ajgeemail/edpAutoCar/System Documentation/ODS powerpoint.pptx

## Obstacle Detection System - Black box

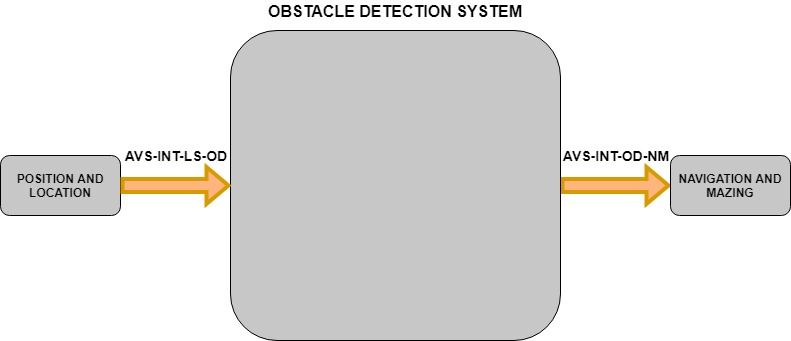
[picture p1: figure]

- Purpose: To detect and locate obstacles

Notes: I’ll be briefly talking to you about the Obstacle Detection System.
It’s purpose is to detect and locate obstacles and output their location to the navigation system for better route planning.

## Obstacle Detection System - Internal

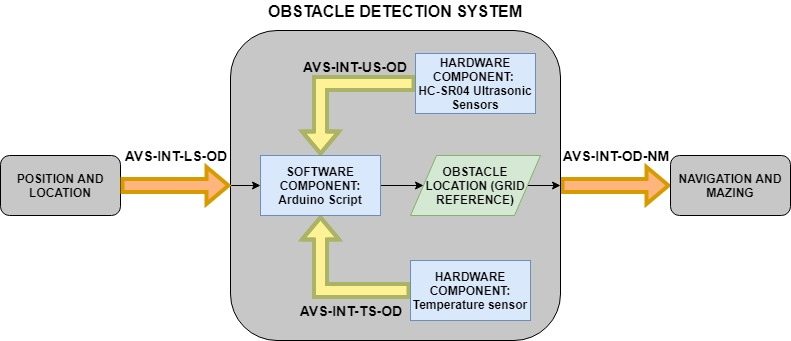
[picture p2: figure]

*if required*

Notes: Internally it will require up to three major interfacing components:
The Ultrasonic sensors
Temperature sensor if required
And the Arduino Script that will combine the inputs and convert into a grid reference to be outputted to the navigation system.

## Obstacle Detection System - Risks

Requirements | Risks
Minimum detect range ≤8cm (based on the geometry of the RC chassis). | Won't detect obstacle in next grid
Accuracy of ±10cm | Incorrect rounding of obstacle location due to smaller obstacle than grid square
Temperature range of 10 - 30°C | Error due to temperature will be outside limits
Obstacles placed in range of 85-95° | Sensors will not accurately detect obstacles
Obstacles placed in only one grid square | Obstacle only allocated to one of the grid squares

Mitigation

Have minimum offset from vehicle as possible

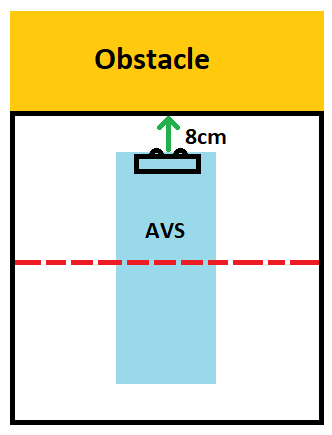
[picture p3: figure]

Notes: There are five major risk factors:
The system shall detect obstacles at a minimum range of ≤8cm .
Otherwise the system may not detect an obstacle in the adjacent grid as can be seen.
To minimise this risk the offset from the chassis will be as small as possible.

There are five major requirements and risk factors:
The system shall detect obstacles at a minimum range of ≤8cm (based on the geometry of the RC chassis).
Otherwise the system may not detect an obstacle in the adjacent grid as can be seen in the image.
Mitigation is to have as small an offset from the chassis as possible.

## Obstacle Detection System - Risks

Requirements | Risks
Minimum detect range ≤8cm (based on the geometry of the RC chassis). | Won't detect obstacle in next grid
Accuracy of ±10cm | Incorrect rounding of obstacle location due to smaller obstacle than grid square
Temperature range of 10 - 30°C | Error due to temperature will be outside limits
Obstacles placed in range of 85-95° | Sensors will not accurately detect obstacles
Obstacles placed in only one grid square | Obstacle only allocated to one of the grid squares

Mitigation

Add negative distance bias such that rounding will be correct

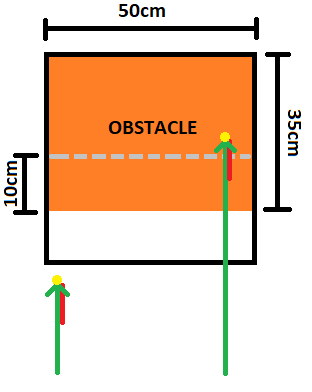
[picture p4: figure]

Notes: 2. The system shall detect obstacles with an accuracy of at least ±10cm.
Otherwise based on the difference in the sizes of the obstacles and squares, rounding may cause location errors.
If required, a distance bias will be added to correct rounding issues.
2. The system shall detect obstacles with an accuracy of at least ±10cm.
Otherwise based on the difference in the sizes of the obstacles and the grid references rounding will incorrectly allocate obstacle locations.
Mitigation as seen in the diagram, is to if required, add a negative distance bias (shown by the red line) to correct rounding issues.

## Obstacle Detection System - Risks

Requirements | Risks
Minimum detect range ≤8cm (based on the geometry of the RC chassis). | Won't detect obstacle in next grid
Accuracy of ±10cm | Incorrect rounding of obstacle location due to smaller obstacle than grid square
Temperature range of 10 - 30°C | Error due to temperature will be outside limits
Obstacles placed in range of 85-95° | Sensors will not accurately detect obstacles
Obstacles placed in only one grid square | Obstacle only allocated to one of the grid squares

Mitigation

Implement a temperature sensor if required

Temperature sensor comparison table:

Notes: 3. Since the speed of sound in air varies with temperature, the system shall operate in a temperature range of 10−30^o C .
Otherwise the error in the speed of sound will cause a distance error exceeding limits.
This range should be reasonable, but as a contingency, a temperature sensor has been selected based on the comparisons shown in the table.
3. Since the speed of sound in air varies with temperature, the system shall operate in a temperature range of 10−〖30〗^o C.
Otherwise the error in the speed of sound will cause a distance error exceeding ±7cm.
It has been determined that this range is reasonable, however if a higher degree of accuracy is needed a temperature sensor will be implemented. As can be seen in the table the sensors were compared based on the cost to error at max range benefit, and from this comparison a contingency component has been selected.

## Obstacle Detection System - Risks

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

Mitigation

Confirm with stakeholder if genuine risk, if so introduce a sweeping technique

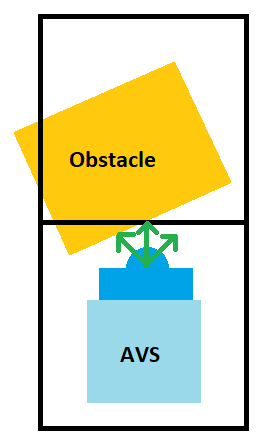
[picture p5: figure]

Notes: 4. The obstacles are expected to be placed at ±5^o relative to the grid otherwise the sensors may not work as they need a perpendicular surface.
A sweeping technique could be used to maximise the chance of getting a perpendicular surface.
4. The obstacles are expected to be in a range of 85−〖95〗^o relative to the grid as the sensors require a near perpendicular surface to operate.
If not, the sensors will not accurately and consistently detect the correct distance of the obstacles.
If it is confirmed by the stakeholder that this is a genuine risk, a sweeping technique will be introduced to maximise chance of getting perpendicular surface.

## Obstacle Detection System - Risks

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

Mitigation

Confirm with stakeholder if genuine risk, if so implement smaller detection grid-squares for higher resolution

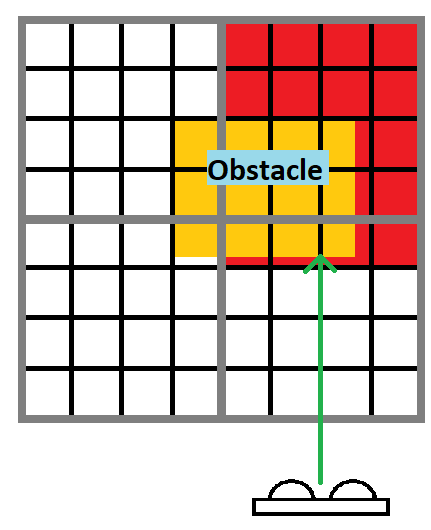
[picture p6: figure]

Notes: 5. The obstacles are expected to be placed in only one grid space, not ‘leaking’ into surrounding squares as shown, because the system will only allocate the obstacle to one of the squares.
If required each square will be broken up into smaller segments for higher resolution as seen.
