ajgeemail/edpAutoCar/Other Resources/Websites used.docx

EDP resources:

- HC-SR04 test results:

https://app.box.com/s/sj7du1n32in2777rcoi2

- Maze solving theory intro:

https://pdfs.semanticscholar.org/db00/fdbec4b93dd68770c78252679679bc5ad9ab.pdf

- Maze solving code:

https://github.com/keremguventurk/Maze-Robot/blob/master/maze%20solver%20code

- Obstace detecting Arduino code:

https://dronebotworkshop.com/hc-sr04-ultrasonic-distance-sensor-arduino/

- HC-SR04 video:

https://www.youtube.com/watch?v=6F1B_N6LuKw&t=1008s

- HC-SR04 video website tutorial:

https://dronebotworkshop.com/hc-sr04-ultrasonic-distance-sensor-arduino/
