ajgeemail/edpAutoCar/System Documentation/Drafts and images/ODS_theoreticalOverview.pdf

## ZEIT4230 Engineering Design Practise (z3419283 - Alex Gee) Obstacle Detection System - Theoretical Overview:

## 1 Hardware

### 1.1 HC-SR04 Ultrasonic Sensors

The HC-SR04 is the main (internal to system) hardware that the ODS will utilise. It has an ultrasonic transmitter and receiver module to measure the distance to an object within its range (2-400cm) [1]. Ultrasonic sensors send out an ultrasonic sound wave pulse, measuring the time taken to detect a reflection and using the known speed of sound to calculate the distance to an object. The HC-SR04 specifically transmits an 8-cycle burst at 40kHz as shown in Figure 1 and returns a pulse width equal to the time taken for a reflection to be detected.

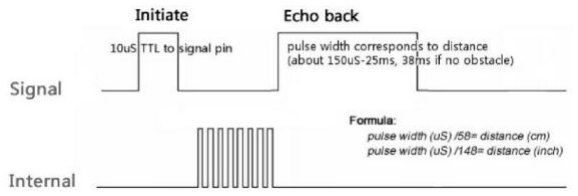
[picture p10: figure]

Figure 1: Operation Signals [1]

This reflection time is the time taken for the signal to travel from the transmitter, to the object and back again, and hence for one way distance d it must be divided by 2 as shown in equation 1.

d =

ct
2

(1)

Where c is speed of sound and t is the pulse width.

Since sound tends to travel outward from the source in all directions, getting a narrow beam is inherently difficult. The expected angular performance of the sensor is shown below in Figure 2.

1

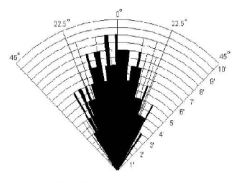
[picture p11: figure]

Figure 2: HC-SR04 Performance Results [1]

The beamwidth ≈ ±30◦
, with a range of up to 400cm (i.e. 8x50cm grid squares), hence the sensor will pick up obstacles left and right of its front but it will be difficult to distinguish which box it is in. As an example some basic trigonometry shown in equation 2, shows ≈ 3 grids to the left and right of the forward box at the 300cm mark will be picked up:

tan(30◦

) = 300cm
x
=⇒ x = 300 tan(30◦
)

= 173.2cm
≈ 3.5 grid squares | (2)

This is shown in Figure 3

300cm

30◦ 30◦

Figure 3: HC-SR04 Beamwidth

### 1.2 TMP36 Temperature Sensor

Based on the temperature dependence of the speed of sound (see Section 2) a temperature sensor may be required. A comparison of the various sensors found at core electronics can be seen below

2

in Table 1.

Sensor | Accuracy (◦C) | ≈ Error at 400cm | Cost | Notes
DHT22 | ±0.5 | ±0.35 | $13.18 | Temperature and humidity
DHT11 | ±2 | ±1.41 | $5.80 | Temperature and humidity
TMP36 | ±2 | ±1.41 | $2.18
LM35DZ | ±0.4 | ±0.28 | $3.40 | Supply Voltage: 4V - 30V

Table 1: Temperature Sensor Options [5], [4], [6], [7], [8]

The error has been calculated by combining equations 1 and 4, with a known distance of 400cm as shown below:

error = dactual − dmeasured | Where: | (3)

dmeasured =

cmeasuredt
2

t =

2d

cactual
cmeasured = 331.4 + 0.6 × (T + Terror)

Note: t = duration, dactual = 400cm, dmeasured = calculated distance from error temperature, cmeasured = calculated speed of sound based on error temperature, cactual = known speed of sound at 20◦C

## 2 Speed of Sound

The speed of sound changes based on the medium it is travelling through. For the purpose of this project the effect of temperature will be the main consideration and its effect can be found according to equation 4 below:
c = 331.5 + 0.6T | (4)
[3] At 20◦C, c = 343m/s which can be used as a good estimate in simple circumstances, however if a higher degree of accuracy is required, temperature will need to be considered.

## 3 Trigonometry

To make the calculations of where the obstacle is relative to the sensors and in turn relative to the Location System device (POZYX), the following trigonometric functions must be understood:

3

adj

θ

opp

hyp

Figure 4: Right Angled Triangle

sin(θ) = opp
hyp
cos(θ) = adj
hyp
tan(θ) = opp
adj
hyp² = opp² + adj²
(5)

4

## References

[1] Cytron Technologies Sdn. Bhd., 2013, Cytron Technologies, accessed 19 March 2018, <http: //web.eece.maine.edu/~zhu/book/lab/HC-SR04%20User%20Manual.pdf>
[2] BBC 2013, BBC, accessed 19 March 2018, <URLofsite>
[3] Wong, C 2000, hypertextbook, accessed 20 March 2018, <https://hypertextbook.com/facts/2000/CheukWong.shtml>
[4] Liu, T Core Electronics, accessed 20 March 2018, <https://core-electronics.com.au/attachments/DHT22.pdf>
[5] Aosong Electronics, accessed 20 March 2018, <https://akizukidenshi.com/download/ds/aosong/DHT11.pdf>
[6] National Semiconductor, accessed 20 March 2018, <http://www.futurlec.com/Linear/LM35DZ.shtml>
[7] Analog Devices, Core Electronics accessed 20 March 2018, <http://dlnmh9ip6v2uc.cloudfront.net/datasheets/Sensors/Temp/TMP35_36_37.pdf>
[8] Core Electronics, accessed 20 March 2018, <https://core-electronics.com.au/search/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>

5
