ajgeemail/edpAutoCar/System Documentation/ODS powerpoint notes.pdf

# Obstacle Detection System - Black box

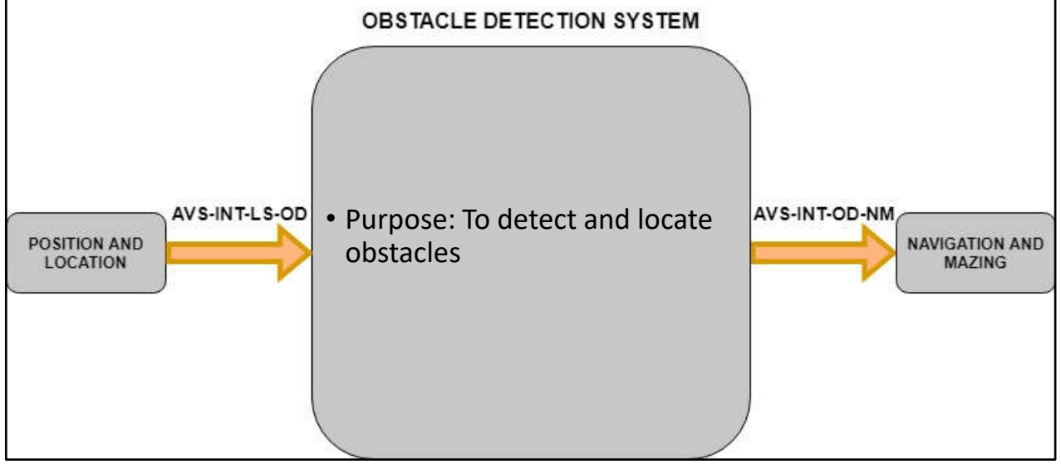
[picture p12: figure]
• Purpose: To detect and locate obstacles

I’ll be briefly talking to you about the Obstacle Detection System.
It’s purpose is to detect and locate obstacles and output their location to the navigation system for better route planning.

# Obstacle Detection System - Internal

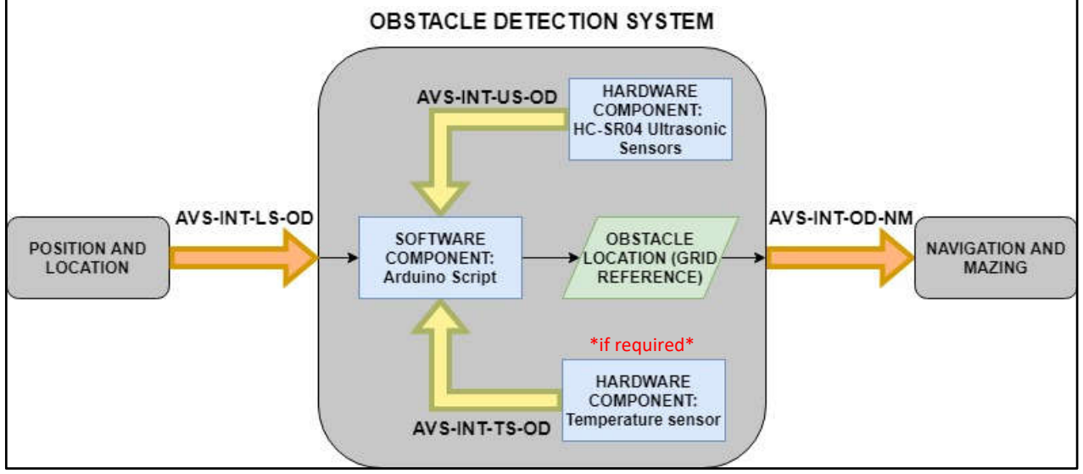
[picture p13: figure]
*if required*

### Internally it will require up to three major interfacing components: 1. The Ultrasonic sensors 2. Temperature sensor if required 3. And the Arduino Script that will combine the inputs and convert into a grid reference

to be outputted to the navigation system.

# Obstacle Detection System - Risks

Requirements | Risks
Minimum detect range ≤ 8 (based on the geometry of the RC chassis). | Won't detect obstacle in next grid

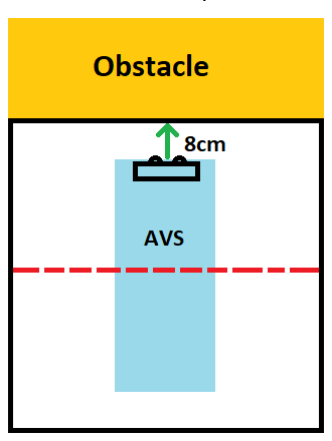
[picture p14: figure]

Accuracy of ±10 | Incorrect rounding of obstacle location due to smaller obstacle than grid square
Temperature range of 10 - 30°C | Error due to temperature will be outside limits
Obstacles placed in range of 85-95° | Sensors will not accurately detect obstacles
Obstacles placed in only one grid square | Obstacle only allocated to one of the grid squares

Mitigation
Have minimum offset
from vehicle as possible

### There are five major risk factors:

1. The system shall detect obstacles at a minimum range of ≤ 8.
Otherwise the system may not detect an obstacle in the adjacent grid as can be seen. To minimise this risk the offset from the chassis will be as small as possible.

# Obstacle Detection System - Risks

Requirements | Risks
Minimum detect range ≤ 8 (based on the geometry of the RC chassis). | Won't detect obstacle in next grid
Accuracy of ±10 | Incorrect rounding of obstacle location due to smaller obstacle than grid square
Temperature range of 10 - 30°C | Error due to temperature will be outside limits
Obstacles placed in range of 85-95° | Sensors will not accurately detect obstacles
Obstacles placed in only one grid square | Obstacle only allocated to one of the grid squares

Mitigation

Add negative distance bias such that rounding will be correct

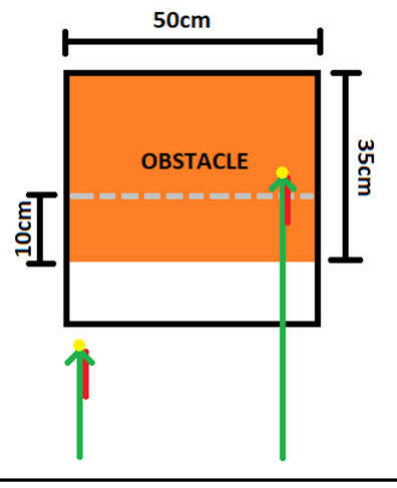
[picture p15: figure]

2. The system shall detect obstacles with an accuracy of at least ±10.

### Otherwise based on the difference in the sizes of the obstacles and squares, rounding

may cause location errors.
If required, a distance bias will be added to correct rounding issues.

# Obstacle Detection System - Risks

Requirements | Risks
Minimum detect range ≤ 8 (based on the geometry of the RC chassis). | Won't detect obstacle in next grid
Accuracy of ±10 | Incorrect rounding of obstacle location due to smaller obstacle than grid square
Temperature range of 10 - 30°C | Error due to temperature will be outside limits
Obstacles placed in range of 85-95° | Sensors will not accurately detect obstacles
Obstacles placed in only one grid square | Obstacle only allocated to one of the grid squares

Mitigation

Implement a temperature
sensor if required

Temperature sensor comparison table:

### 3. Since the speed of sound in air varies with temperature, the system shall operate in a

temperature range of 10 − 30.
Otherwise the error in the speed of sound will cause a distance error exceeding limits.

### This range should be reasonable, but as a contingency, a temperature sensor has been

selected based on the comparisons shown in the table.

# Obstacle Detection System - Risks

Requirements | Risks
Minimum detect range ≤ 8 (based on the geometry of the RC chassis). | Won't detect obstacle in next grid
Accuracy of ±10 | Incorrect rounding of obstacle location due to smaller obstacle than grid square
Temperature range of 10 - 30°C | Error due to temperature will be outside limits
Obstacles placed in range of 85-95° | Sensors will not accurately detect obstacles
Obstacles placed in only one grid square | Obstacle only allocated to one of the grid squares

Mitigation

Confirm with stakeholder if genuine risk, if so introduce a sweeping

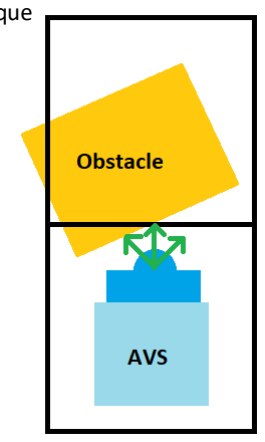
[picture p16: figure]

technique

### 4. The obstacles are expected to be placed at ±5 relative to the grid otherwise the

sensors may not work as they need a perpendicular surface.

### A sweeping technique could be used to maximise the chance of getting a perpendicular

surface.

# Obstacle Detection System - Risks

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

Mitigation
Confirm with stakeholder if genuine risk, if so implement smaller detection grid-squares for higher resolution

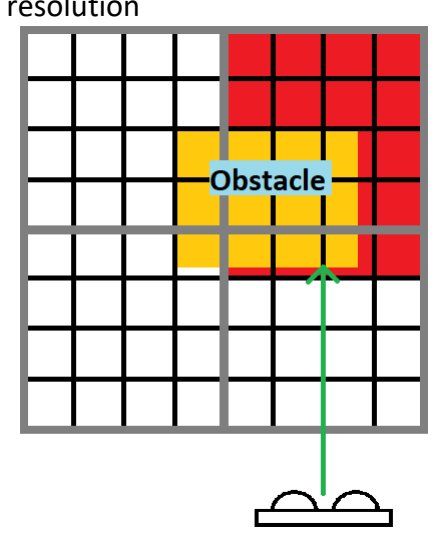
[picture p17: figure]

### 5. The obstacles are expected to be placed in only one grid space, not ‘leaking’ into surrounding squares as shown, because the system will only allocate the obstacle to one

of the squares.

### If required each square will be broken up into smaller segments for higher resolution as

seen.
