ajgeemail/edpAutoCar/System Documentation/Project Schedule.pdf

Project Execution | 05/03/2018 09…15/06/2018 18… | 600 | 0%
Initial Planning Phase | 05/03/2018 09…27/03/2018 12… | 132 | 0%
SRS Development | 05/03/2018 09…23/03/2018 18… | 120 | 0% | u
Initial Purchase Requirements Identification | 05/03/2018 09…23/03/2018 18… | 120 | 0% | u
Project Planning Report Due Date | 23/03/2018 09…23/03/2018 09… | | | u
Project Planning Report Presentation | 27/03/2018 12…27/03/2018 12… | | | u
Sub-system Development Phase | 05/03/2018 09…20/04/2018 18… | 280 | 0%
Hardware Development | 05/03/2018 09…13/04/2018 18… | 240 | 0%
Initial testing of supplied hardware | 05/03/2018 09…23/03/2018 18… | 120 | 0% | u
Testing of purchased hardware | 26/03/2018 09…06/04/2018 18… | 80 | 0% | u
CAD design process | 05/03/2018 09…30/03/2018 18… | 160 | 0% | u
3D printing and reprint buffer | 02/04/2018 09…13/04/2018 18… | 80 | 0% | u
Software Development | 05/03/2018 09…20/04/2018 18… | 280 | 0%
Software Architectural and Detailed Design | 05/03/2018 09…06/04/2018 18… | 200 | 0% | u
Software Testing | 09/04/2018 09…20/04/2018 18… | 80 | 0% | u
Integration Phase | 16/04/2018 09…04/05/2018 18… | 120 | 0%
Integration of sub-systems | 16/04/2018 09…20/04/2018 18… | 40 | 0% | u
Testing of sub-system integration | 23/04/2018 09…04/05/2018 18… | 80 | 0% | u
System Qualification and Testing Phase | 30/04/2018 09…04/06/2018 09… | 200 | 0%
Sub-system verification | 30/04/2018 09…11/05/2018 18… | 80 | 0% | u
System verification | 14/05/2018 09…01/06/2018 18… | 120 | 0% | u
System Verification Due Date | 04/06/2018 09…04/06/2018 09… | | | u
Develop components / Features | 02/04/2018 09…15/06/2018 18… | 440 | 0%
Preliminary design review/documentation | 02/04/2018 09…03/05/2018 10… | 185 | 0% | u
Progress review | 01/05/2018 09…01/05/2018 09… | | | u
Progress review report | 04/05/2018 09…04/05/2018 09… | | | u
Final Design review/documentation | 03/05/2018 10…15/06/2018 18… | 255 | 0% | u
System Verification Due Date | 04/06/2018 09…04/06/2018 09… | | | u
Project Final Report Due Date | 15/06/2018 09…15/06/2018 09… | | | u

Project Execu

Initial Planning Phase

SRS Development

Initial Purchase Requirements Identification

Sub-system Development Phase

Hardware Development

Initial testing of supplied hardware

Testing of purchased hardware

CAD design process

3D printing and reprint buffer

Software Development

Software Architectural and Detailed Design

Software Testing

Integration Phase

Integration of sub-systems

Testing of sub-system integration

System Qualification and Testing P

Sub-system verification

System verification

Develop comp

Preliminary design review/documentation

Final Design r

Task name | Start date | End date | Duration (hour) | ProgressAssigne…

Total Estimate 05/03/2018 09…15/06/2018 18… 600
