ajgeemail/edpAutoCar/Other Resources/Obstacle Sensing System Black Box Block Diagram.jpg

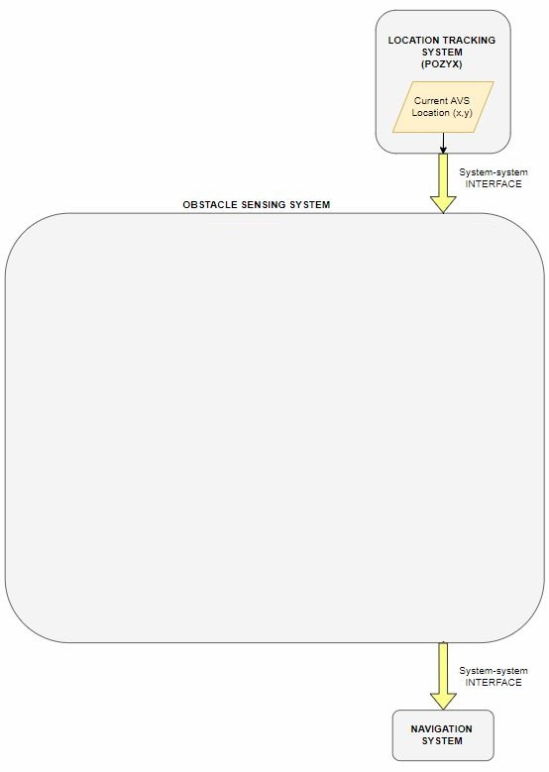
Other Resources/Obstacle Sensing System Black Box Block Diagram.jpg
