ajgeemail/edpAutoCar/Other Resources/Obstacle Sensing System Block Diagram.JPG

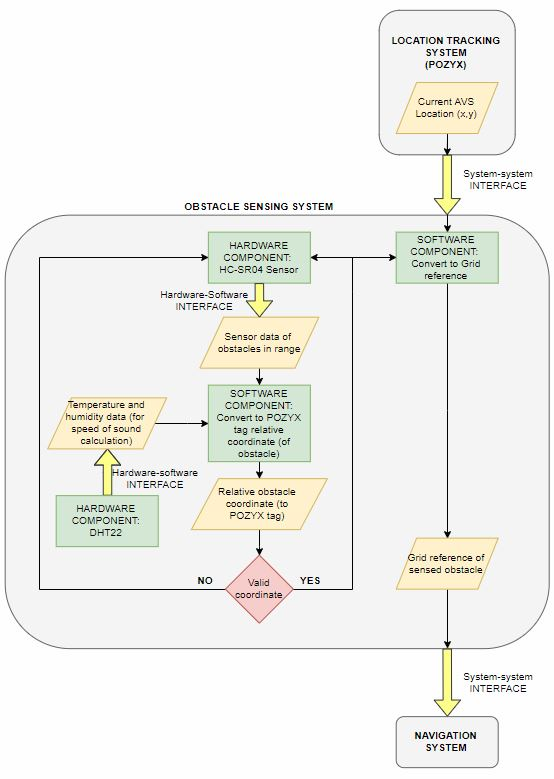
Other Resources/Obstacle Sensing System Block Diagram.JPG
