ajgeemail/edpAutoCar/System Documentation/Drafts and images/obstacleDiagram.png

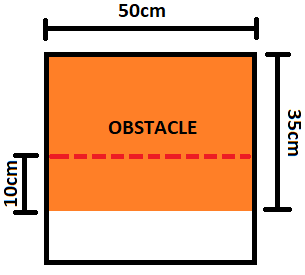
System Documentation/Drafts and images/obstacleDiagram.png
