ajgeemail/edpAutoCar/(list of files, drawings)

Other design files:
Other Resources/Obstacle Sensing Schematic.fzz
