ajgeemail/edpAutoCar/(commit log)

2018-03-10 Split obstacle sensor code into header and source files and created a main ino file to run everything from (botMain).
2018-03-11 Added yaw angle capability, including calculations for correct sensor offset x and y components based on changing yaw
    [ObstacleSensor.cpp, ObstacleSensor.h, botMain.ino]
2018-03-12 Added detectAllSensors and individual sensor functions
2018-03-15 Added obstacle sensing fritzing schematic
    [Obstacle Sensing Schematic.fzz]
2018-03-25 ODS_ssrs completed and powerpoint modified
2018-03-25 Added notes to powerpoint
2018-03-26 Reduced Powerpoint notes further
2018-04-02 Created ObstacleDetection class and completed functionality - now no ODS functions declared inside botMain. This will also be useful if testing different arrangements/configurations of sensors.
2018-04-03 Moved printing of all distance and grid reference data to printDistance function in ObstacleSensor class.
2018-04-04 Static iterations initialisation correction
    [ObstacleDetection.cpp, ObstacleDetection.h]
2018-04-04 Changed WProgram.h to Arduino.h (updated version)
2018-04-16 Changed map print to show whole array
2018-06-08 Reprioritsed forwards and reverse
    [Navigator.cpp, Navigator.h, ObstacleDetection.cpp, ObstacleDetection.h, ObstacleSensor.cpp, ObstacleSensor.h]
